ManeyYamazin/OtemotoRocket/docs/otemoto_rocket_blueprint_a4.pdf

おてもとロケット（せっけいず） | 印刷確認用スケール (50.0 mm)

① うちがわ（のり用）

▲ あたま

のりしろ

のりしろ

のりしろ

のりしろ | のりしろ

② そとがわ

のりしろ

▲ あたま

③ あてがみ

①の しろい所に

のせるだけ！

（のりは ぬらないよ）

★ もつところ ★

ここを もって とる

グレー：のりしろ | てん線：おる線 | くろい線：きる線 | グレーの線：きらない線

## ★ つくり方

### 1. きる： くろい 線に そって、①・②・③を はさみで きります。

### 2. のりぬり： ①の しろい所に ③を のせ、グレーの所に のりを ぬります。（③はとる）

### 3. はる： ①の 上に ②を かさねて、ぴったり はりあわせます。

### 4. おる： あたまを てんせんで ２回 おって、のりで とめます。

© 2026 ManeyYamazin / CC BY 4.0 | | | PDF
