ManeyYamazin/OtemotoRocket/stl/launcher_cap_nozzle.3mf

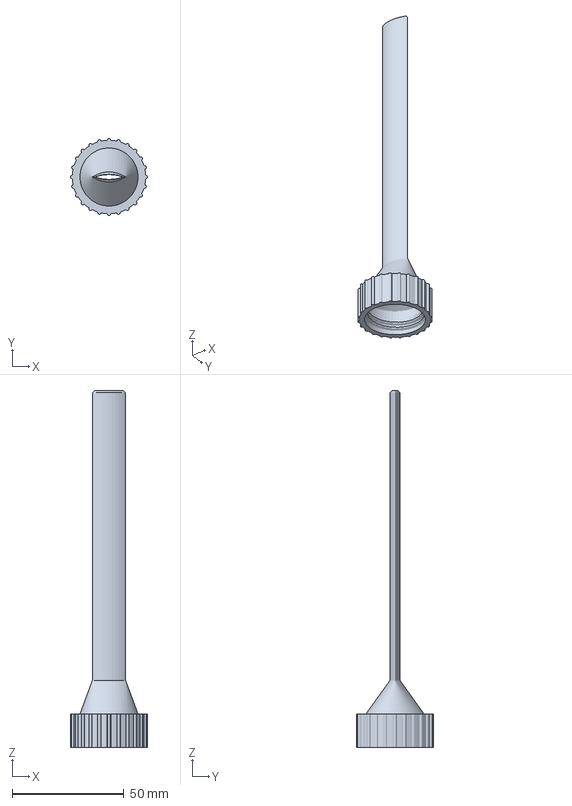
[picture p5: CAD file, 2026-10-24]
stl/launcher_cap_nozzle.3mf
34.6 x 34.6 x 160.1 mm
