ManeyYamazin/OtemotoRocket/(list of files, cad)

Other CAD files:
stl/launcher_cap_nozzle.stl
