ManeyYamazin/OtemotoRocket/(commit log)

2026-10-24 Initial release: OtemotoRocket launch system with blueprints, 3D models, and documentation
    [launcher.scad, launcher_cap_nozzle.3mf, launcher_cap_nozzle.stl]
2026-10-24 Docs: Detail real 4-type 8-sun chopstick sleeve rocket fabrication (150mm cut, 10mmx2 fold, origami fins)
